niyoseris/pocket-ebook-reader/hardware/enclosure/stl/govde.stl

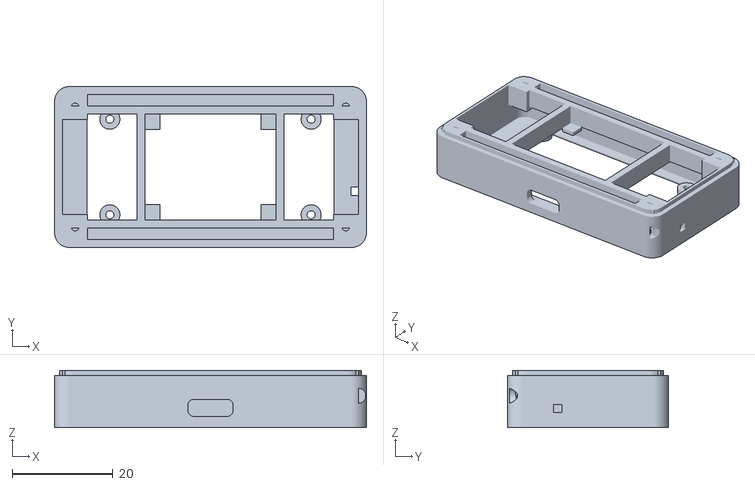
[picture p1: CAD file, 2026-10-10]
hardware/enclosure/stl/govde.stl
62.0 x 32.0 x 11.4
