niyoseris/pocket-ebook-reader/hardware/enclosure/stl/kapak.stl

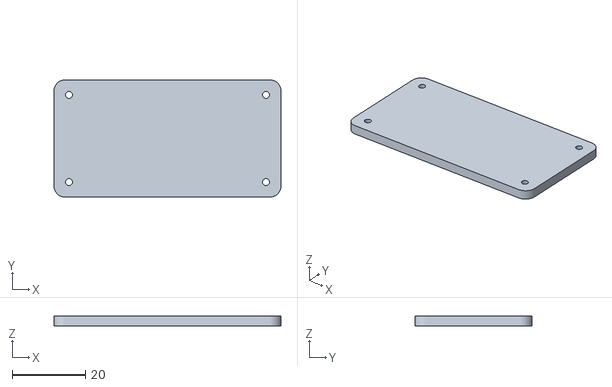
[picture p2: CAD file, 2026-10-10]
hardware/enclosure/stl/kapak.stl
62.0 x 32.0 x 2.60
