niyoseris/pocket-ebook-reader/hardware/enclosure/stl/panel-test.stl

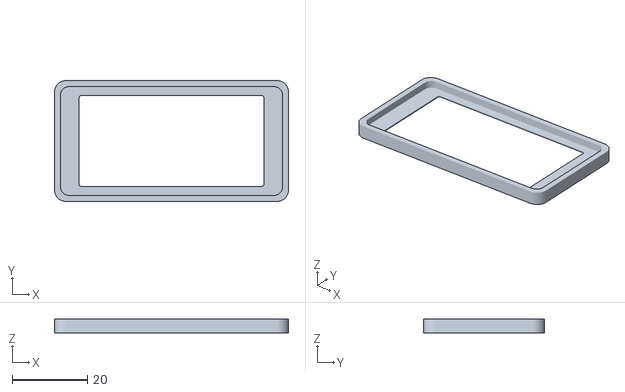
[picture p3: CAD file, 2026-10-10]
hardware/enclosure/stl/panel-test.stl
62.0 x 32.0 x 3.60
