niyoseris/pocket-ebook-reader/(commit log)

2026-10-10 Pocket Reader 1.0.0 — open-source pocket e-ink reader
    An ESP32-C3 book reader: 2.13" 250x122 e-paper, 1S Li-Po, three buttons,
    62 x 32 x 13 mm. One firmware, two build tiers (breadboard and custom PCB).
    Design files, firmware and tooling are all generated from single sources, so
    they cannot drift apart:
    * every 2D drawing and the 3D model read the same placement.csv
    * schematic, net list and connection table come from gen_netlist.py
    * both language versions of the site are built from one template
    Twelve errors were found and fixed before any hardware was built — six by
    reading datasheets against unchecked assumptions, four by geometry
    validators, two by cross-checks between the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
    [case.scad, connections.csv, govde.stl, kapak.stl, panel-test.stl, placement.csv]
2026-10-10 Use the real repository URL in the thread and licence template
    The repo is live, so the placeholder github.com/YOU/... in the Twitter
    thread, and <user>/... in the licence attribution template, are replaced
    with the real URL. Post 16 and the thread header are re-counted.
    Also repairs the thread's post markers, which a rewrite pass had flattened
    from **N/** to bare numbers, and renames the last Turkish marker token
    (DOĞRULANMADI -> UNVERIFIED) across the generator, the net list and both
    language versions of the docs.
2026-10-10 English-only repository; fix the first real compile error
    The repository is now a single-language English project. The Turkish
    translations of the documents, the Turkish build of the site, and the
    Twitter drafts were written for the author's own use and do not belong in
    a public repository, so they have been moved out of it.
    Content changes:
    * buttons: BTN_UP / BTN_DOWN / BTN_MENU were defined both as pin macros in
    config.h and as enum members in buttons.h. The preprocessor rewrote the
    enum and buttons.cpp failed to compile. Pins keep the BTN_ prefix; the
    button events are now EV_UP / EV_DOWN / EV_MENU / EV_ANY_WAKE. This is
    the first genuine compile error the project has ever surf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
    [build_site.py, buttons.cpp, buttons.h, main.cpp, ui.cpp]
2026-10-10 Fix the second compile error and a real deep-sleep hardware requirement
    Two things, and the second is more important than the first.
    power.cpp called rtc_gpio_pullup_en() / rtc_gpio_pulldown_dis(), and used
    BTN_MASK_* without including buttons.h. The include was a one-line fix. The
    RTC calls were not: ESP32-C3 has no RTCIO subsystem at all
    (SOC_RTCIO_PIN_COUNT is 0) and ESP-IDF declares no gpio_sleep_* API for it,
    so those functions do not exist on this part and never will.
    That has a consequence the documentation had wrong. docs/04 told easy-build
    readers that "external pull-ups and capacitors are not needed" because the
    firmware enables INPUT_PULLUP. That is false: the digital pull is po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
    [power.cpp]
2026-10-10 Use the ESP32-C3 deep-sleep wakeup API, not the ESP32 ext1 API
    The whole wake path was written for ESP32-classic ext1, which does not
    exist on this part. SOC_PM_SUPPORT_EXT_WAKEUP is undefined for the
    ESP32-C3, so esp_sleep_enable_ext1_wakeup(), esp_sleep_get_ext1_wakeup_status()
    and the ESP_SLEEP_WAKEUP_EXT1 cause are all absent. The C3 has
    SOC_GPIO_SUPPORT_DEEPSLEEP_WAKEUP instead, with its own entry points.
    esp_sleep_enable_ext1_wakeup() -> esp_deep_sleep_enable_gpio_wakeup()
    esp_sleep_get_ext1_wakeup_status() -> esp_sleep_get_gpio_wakeup_status()
    ESP_SLEEP_WAKEUP_EXT1 -> ESP_SLEEP_WAKEUP_GPIO
    power.cpp, buttons.cpp, power.h and config.h are updated, and the
    ES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
2026-10-10 Firmware now compiles on both targets; record the three errors it found
    All four CI jobs are green. The firmware had never been through a compiler
    and it showed: three errors were hiding in that state, and only a compiler
    could have found any of them. They are now errors 13-15 in the changelog,
    which brings the list to fifteen and keeps the headline number countable
    against the table.
    The README's status section said "Compiled: no", which was true when it was
    written and is not any more. It now says what is actually true, and separates
    the two claims that were being conflated: the firmware builds, and nothing has
    ever been flashed to a real device. Those are not the same thing and the secon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
2026-10-10 Verify the last 13 pin numbers, and fix a footprint that could not be built
    Every pin in the netlist now comes from a primary source; gen_netlist.py
    --check reports 0 unverified. Before this, a fabrication order would have
    been built on guesses for the USB-C receptacle, the USBLC6 array and the
    panel boost MOSFET.
    Three things the verification turned up:
    * The USB-C receptacle's VBUS and GND are four-pad groups (A4/A9/B4/B9 and
    A1/A12/B1/B12), not the pairs I had assumed. All four of each are now
    connected; otherwise half of them would have been left floating. The
    shield is connected to GND as well.
    * USBLC6-2SC6 splits each protected line across two pins so the current can
    share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
    [connections.csv]
